hgschmie/esp32-dcf77/(commit log)

2026-11-09 Document SuperMini antenna and LED wiring
2026-11-09 add 3d printed case
    [dcf77_case.scad]
